eSpark-Consulting-Group/ezlo-rf-ir-blaster/README.md

# Scope of Work

1. The first task will be to convert the design from KiCAD into Altium.
2. This will be followed by a review phase where the whole design will be checked thoroughly for any errors or issues or enhancements. This will be done keeping in mind that prototypes of this design are are already tested and working properly.
3. After this, the design will be forwarded to fabrication.
