eSpark-Consulting-Group/ezlo-rf-ir-blaster/docs/Client-Files/IR-RF Blaster revA/BOM/ir-rf-blaster-bom-revA.xls

IR-RF-BLaster revA BOM - Exported April 3rd 2023
Ref | Qnty | Value | Voltage | Cmp name | Footprint | Description | Assembly | LCSC # | Mfr | MPN
AE1, | 1 | Antenna |  | Antenna | Ezlo:RF-433-Helical | Antenna | YES | C381188 | DreamLNK |  | https://datasheet.lcsc.com/lcsc/1912111437_DreamLNK-T14-433M_C381188.pdf
C1, C11, | 2 | 1uF |  | C | Capacitor_SMD:C_0402_1005Metric | Unpolarized capacitor | YES | C1592 | CL10A105KO8NNNC
C2, C9, | 2 | 22uF |  | C | Capacitor_SMD:C_1206_3216Metric | Unpolarized capacitor | YES | C408152 | GRM31CR70J226KE19L
C3, C4, C10, | 3 | 0.1uF |  | C | Capacitor_SMD:C_0402_1005Metric | Unpolarized capacitor | YES | C24452 | CL10B104JB8NNNC
C5, | 1 | 4.7uF |  | C | Capacitor_SMD:C_0402_1005Metric | Unpolarized capacitor | YES | C1705 | CL10A475KP8NNNC
C6, C7, | 2 | 220uF | 10V | C_Polarized_US | Capacitor_SMD:CP_Elec_6.3x5.4 | Polarized capacitor, US symbol | YES | C267466 | RT1A221M0605
C8, | 1 | 10uF | 16V | C | Capacitor_SMD:C_0603_1608Metric | Unpolarized capacitor | YES | C92487 | CL10A106MO8NQNC
D1, | 1 | LED_GREEN |  | LED_GREEN | LED_SMD:LED_0603_1608Metric | LED GREEN 0603, high efficiency, Vf=3.0V | YES | C84267 | NCD0603G1
D2, D3, D4, D5, D6, D7, D8, D9, | 8 | IR333-A |  | LED_Filled | LED_THT:LED_D5.0mm | Light emitting diode, filled shape | YES | C95407 | IR333-A
D10, | 1 | SMF5.0CA |  | SMF5V0A | Diode_SMD:D_SMF | 200W unidirectional Transil Transient Voltage Suppressor, 5Vrwm, SMF | YES | C2980402 | SMF5.0CA
F1, | 1 | 1A |  | Polyfuse | Fuse:Fuse_0603_1608Metric | Resettable fuse, polymeric positive temperature coefficient | YES | C2757929 | BSMD0603L-100
H1, H2, | 2 | MountingHole |  | MountingHole | MountingHole:MountingHole_2.2mm_M2 | M2 screw, self tapping | YES | - | screw
J1, | 1 | VoltLink_target |  | VoltLink_target | Voltlog:VoltLink-vertical | Voltlog Link ESP programming header, pinout designed for target side. | DNP | C145963
J2, | 1 | TYPE-C-31-M-17 |  | USB_C_Receptacle_PowerOnly_6P | Ezlo:TYPE-C-31-M-17 | USB Power-Only 6P Type-C Receptacle connector | YES | C283540 | TYPE-C-31-M-17
Q1, | 1 | YJL2302B |  | DMG2302U | Package_TO_SOT_SMD:SOT-23 | 4.2A Id, 20V Vds, N-Channel MOSFET, SOT-23 | YES | C699316 | YJL2302B
R1, R3, R10, | 3 | 10K |  | R_US | Resistor_SMD:R_0402_1005Metric | Resistor, US symbol | YES |  | GENERIC 1%
R2, | 1 | 1K |  | R_US | Resistor_SMD:R_0402_1005Metric | Resistor, US symbol | YES |  | GENERIC 1%
R4, R9, | 2 | 100R |  | R_US | Resistor_SMD:R_0402_1005Metric | Resistor, US symbol | YES |  | GENERIC 1%
R5, R6, R7, R8, | 4 | 14R |  | R_US | Resistor_SMD:R_1210_3225Metric | Resistor, US symbol | YES |  | GENERIC 1%
R11, R12, | 2 | 5K1 |  | R_US | Resistor_SMD:R_0402_1005Metric | Resistor, US symbol | YES | C25905 | GENERIC 1%
SW1, | 1 | USER |  | SW_Push | Ezlo:Switch_YTS-B003-2A | Push button switch, generic, two pins | YES | C2910695 | YTS-B003-2A
U1, | 1 | ESP32-S3-WROOM-1U-N4 |  | ESP32-S3-WROOM-1 | Espressif:ESP32-S3-WROOM-1 |  | YES | C2913197 | ESP32-S3-WROOM-1-N4
U2, | 1 | IRM-H638T/TR2 |  | IRM-H638T | Package_SO:SO-4_4.4x4.3mm_P2.54mm | Photo Modules for PCM Remote Control Systems | YES | C91447 | IRM-H638T/TR2
U3, | 1 | IRM-3638T |  | TSOP382xx | OptoDevice:Vishay_MINICAST-3Pin | Photo Modules for PCM Remote Control Systems | DNP | C16216
U4, | 1 | LR1107 |  | LR1107 | Package_TO_SOT_SMD:SOT-89-3 | 600mA FAST ULTRA LOW Dropout Regulator | YES | C171498 | LR1107G-33-AB3-C-R
U5, | 1 | E07-400M10S |  | EBYTE-E07-M10S | Ezlo:EBYTE-E07-M10S | EBYTE CC101 based modules E07-400M10S and E07-900M10S 14*20mm size | YES |  | EBYTE-E07-M10S | <--- cost from Ebyte for this module is $1.53/pc @5K qty
N1, | 1 | Housing |  | Housing |  | Housing | YES |  | custom
PCB | 1 |  |  |  | FR4, TG130, HASL, 1.6mm, green soldermask, white silkscreen
Packaging | 1 |  |  |  | Box, User Manual
USB-C Cable | 1 |  |  |  | USB-C to USB Type-A Cable, Power Only, 1m, 5V 1A rating
DNP = DO NOT POPULATE
