eSpark-Consulting-Group/ezlo-rf-ir-blaster/docs/Client-Files/IR-RF Blaster revA/enclosure/IR-New/AssemblyNew.STEP

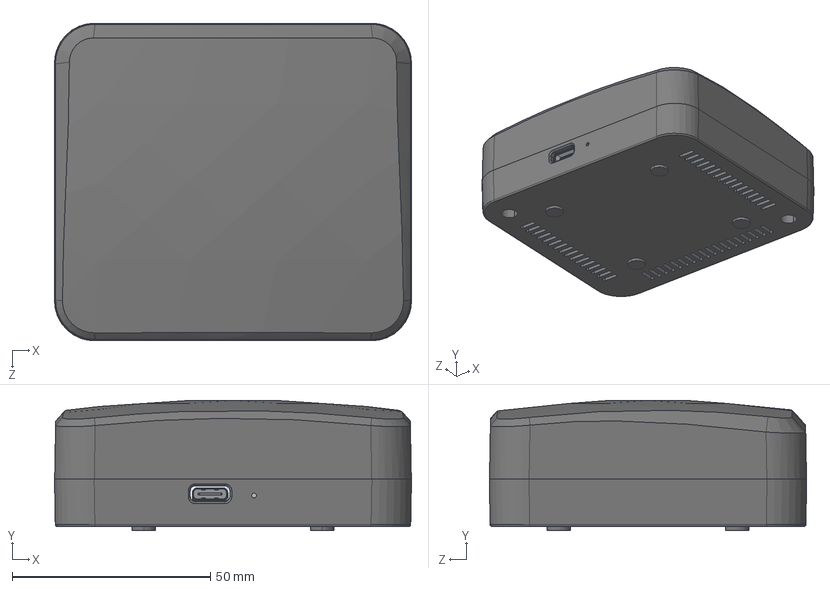
[picture p2: CAD file, 2023-08-09]
docs/Client-Files/IR-RF Blaster revA/enclosure/IR-New/AssemblyNew.STEP
90.1 x 32.8 x 80.1 mm
Body New
SOLID.step x 8
SOLID-0.step
SOLID-1.step
SOLID-2.step
SOLID-3.step x 2
SOLID-4.step
SOLID-5.step x 4
SOLID-6.step x 2
SOLID-7.step
COMPOUND-8.step
SOLID-9.step
SOLID-11.step x 6
COMPOUND-12.step
SOLID-13.step
COMPOUND-14.step
SOLID-15.step
COMPOUND-16.step
PCB.step
led placer new
