eSpark-Consulting-Group/ezlo-rf-ir-blaster/docs/Client-Files/IR-RF Blaster revA/enclosure/IR-New/IR-New/IR_Top.STEP

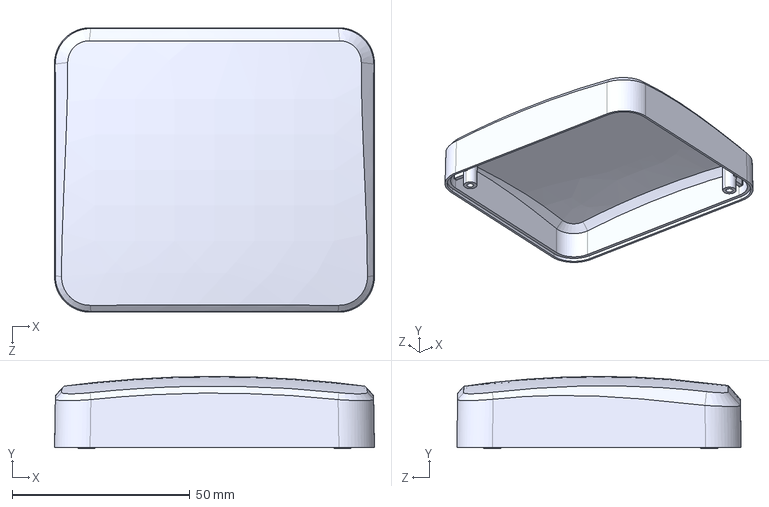
[picture p3: CAD file, 2023-08-09]
docs/Client-Files/IR-RF Blaster revA/enclosure/IR-New/IR-New/IR_Top.STEP
90.0 x 20.3 x 80.0 mm
