eSpark-Consulting-Group/ezlo-rf-ir-blaster/docs/Client-Files/IR-RF Blaster revA/enclosure/IR-New/IR-New/IR_Base.STEP

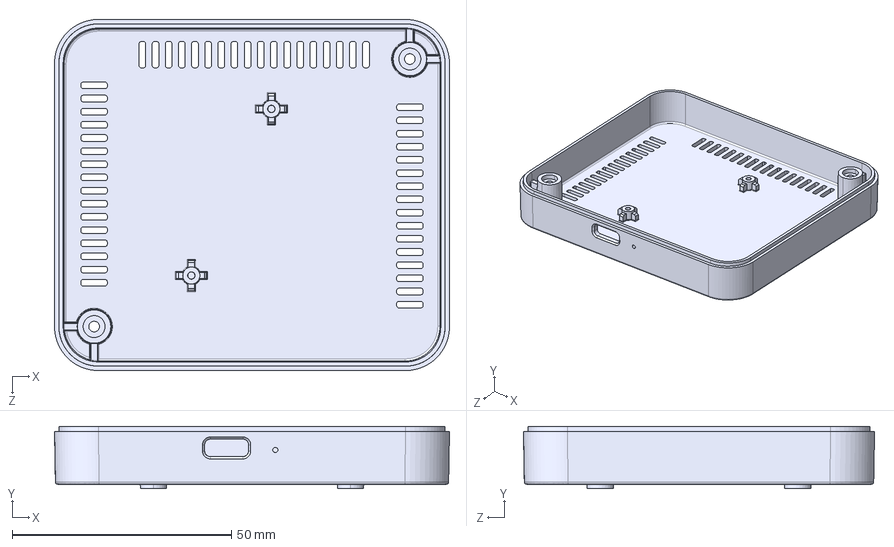
[picture p4: CAD file, 2023-08-09]
docs/Client-Files/IR-RF Blaster revA/enclosure/IR-New/IR-New/IR_Base.STEP
90.1 x 14.2 x 80.1 mm
