eSpark-Consulting-Group/ezlo-rf-ir-blaster/docs/Client-Files/IR-RF Blaster revA/enclosure/IR-New/led placer new.STEP

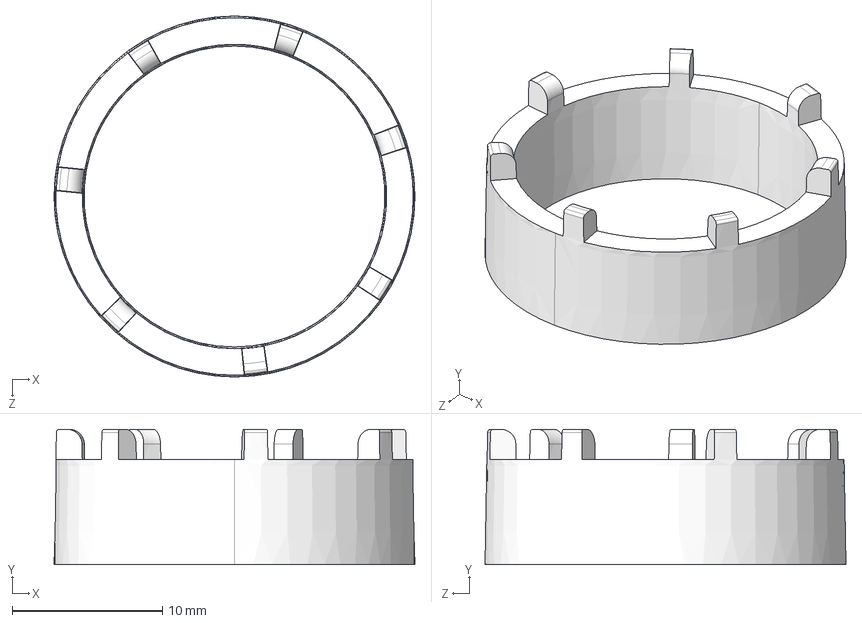
[picture p5: CAD file, 2023-08-09]
docs/Client-Files/IR-RF Blaster revA/enclosure/IR-New/led placer new.STEP
24.0 x 9.00 x 24.0 mm
