eSpark-Consulting-Group/ezlo-rf-ir-blaster/(list of files, cad)

Other CAD files:
docs/Client-Files/IR-RF Blaster revA/enclosure/IR-New/IR-New/IR_Base.SLDPRT
docs/Client-Files/IR-RF Blaster revA/enclosure/IR-New/IR-New/IR_Base.STL
docs/Client-Files/IR-RF Blaster revA/enclosure/IR-New/IR-New/IR_Top.SLDPRT
docs/Client-Files/IR-RF Blaster revA/enclosure/IR-New/IR-New/IR_Top.STL
docs/Client-Files/IR-RF Blaster revA/enclosure/IR-New/IR_Base.SLDPRT
docs/Client-Files/IR-RF Blaster revA/enclosure/IR-New/IR_Base.STL
docs/Client-Files/IR-RF Blaster revA/enclosure/IR-New/IR_Top.SLDPRT
docs/Client-Files/IR-RF Blaster revA/enclosure/IR-New/IR_Top.STL
docs/Client-Files/IR-RF Blaster revA/enclosure/IR-New/led placer new.SLDPRT
docs/Client-Files/IR-RF Blaster revA/enclosure/IR-New/led placer new.STL
