eSpark-Consulting-Group/ezlo-rf-ir-blaster/docs/Client-Files/IR-RF Blaster revA/IR-RF-Blaster revA Schematic.pdf

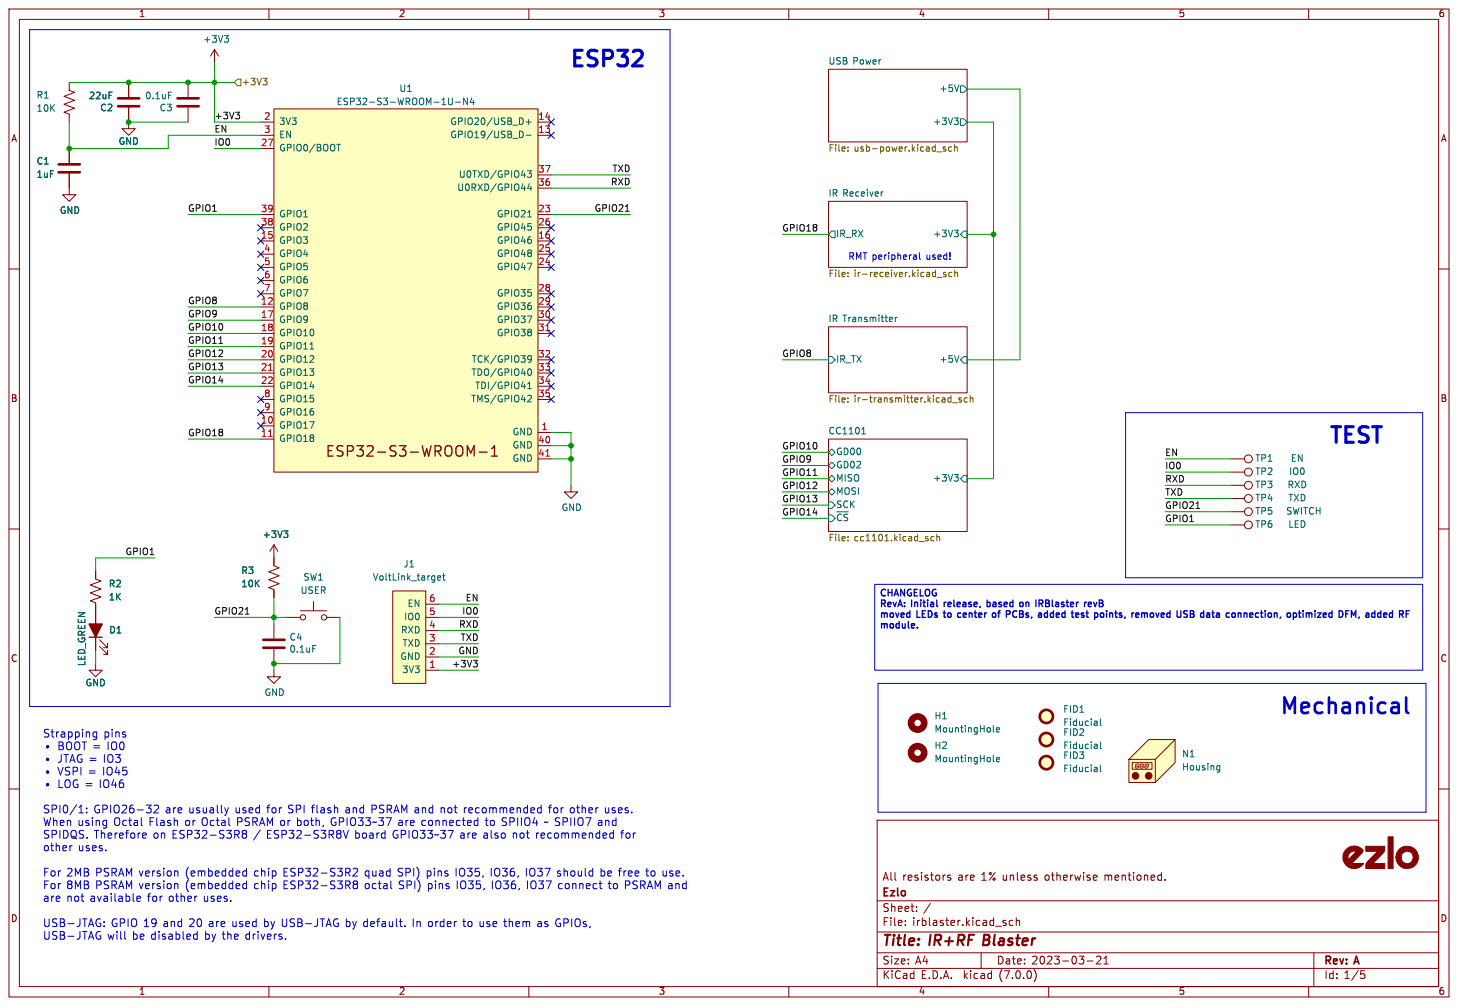
[picture p6: page 1]

IR Receiver File: ir-receiver.kicad_sch+5V

IR Transmitter File: ir-transmitter.kicad_sch

+3V3 ~{CS} SCK MOSI MISO

RevA: Initial release, based on IRBlaster revB moved LEDs to center of PCBs, added test points, removed USB data connection, optimized DFM, added RF module. +3V3 R3

Id: 1/5 Title: IR+RF Blaster File: irblaster.kicad_sch Sheet: / Ezlo All resistors are 1% unless otherwise mentioned.

are not available for other uses. USB-JTAG: GPIO 19 and 20 are used by USB-JTAG by default. In order to use them as GPIOs, USB-JTAG will be disabled by the drivers.

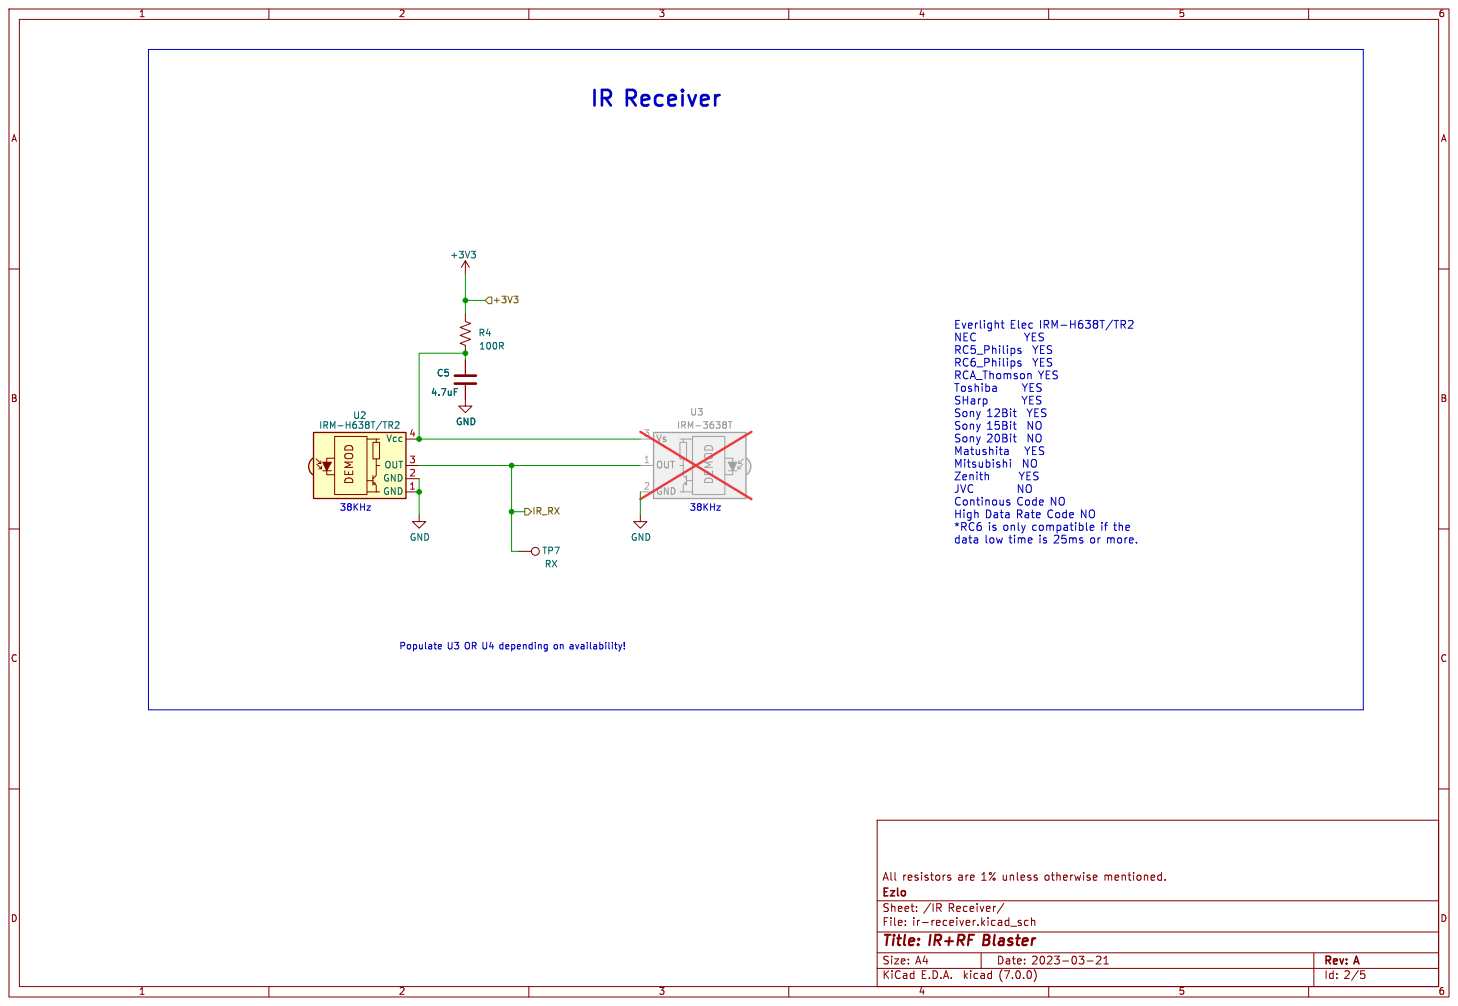
[picture p7: page 2]

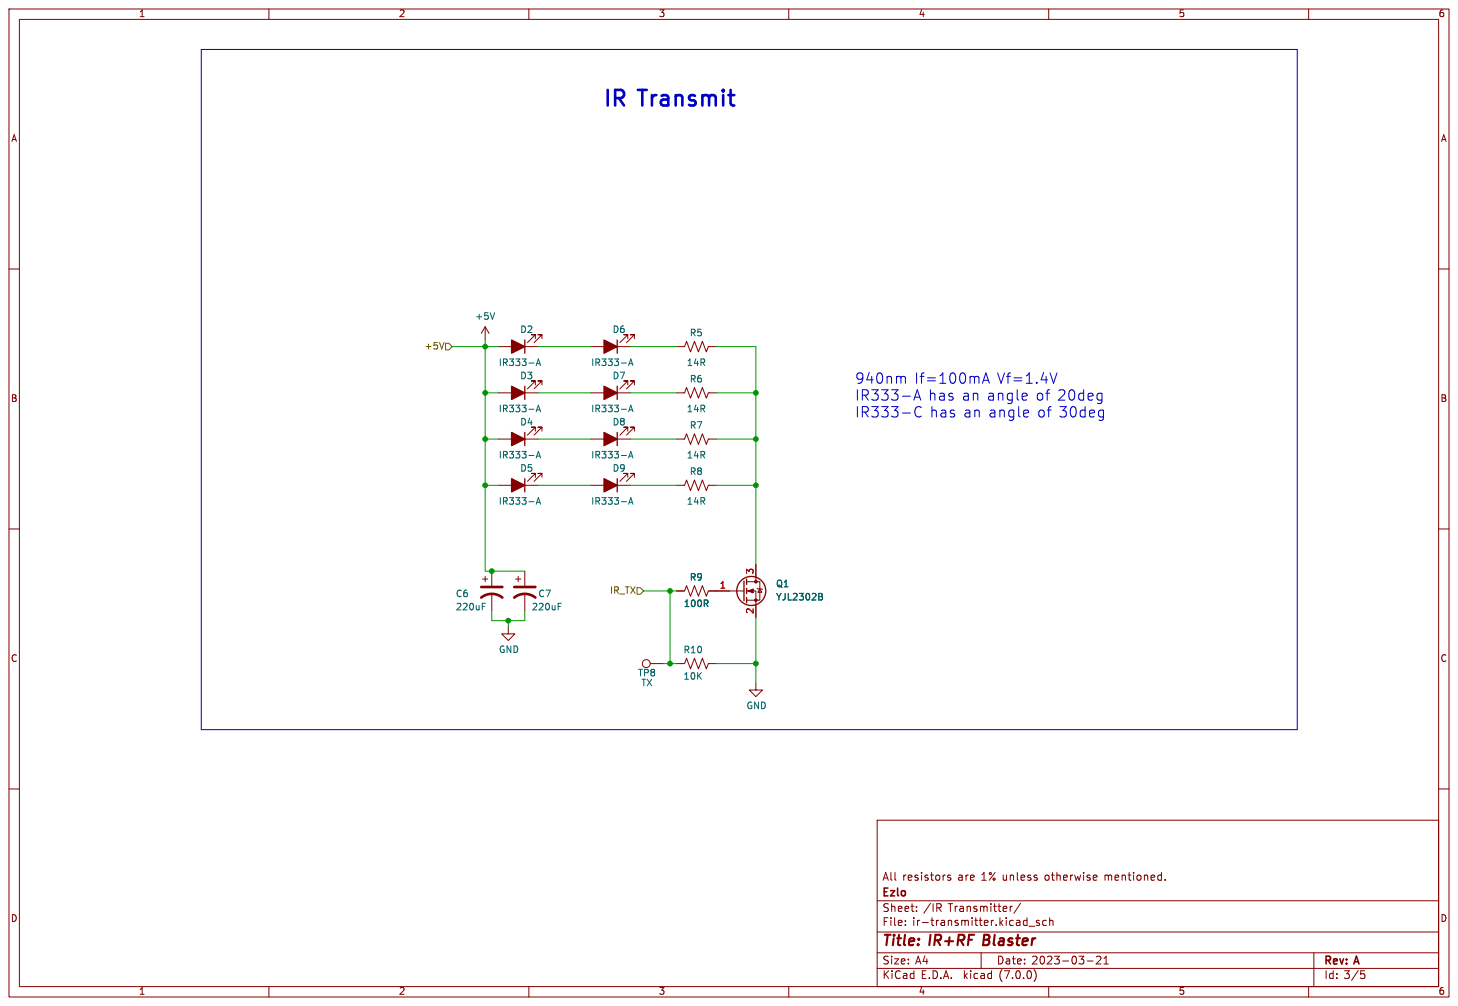
[picture p8: page 3]

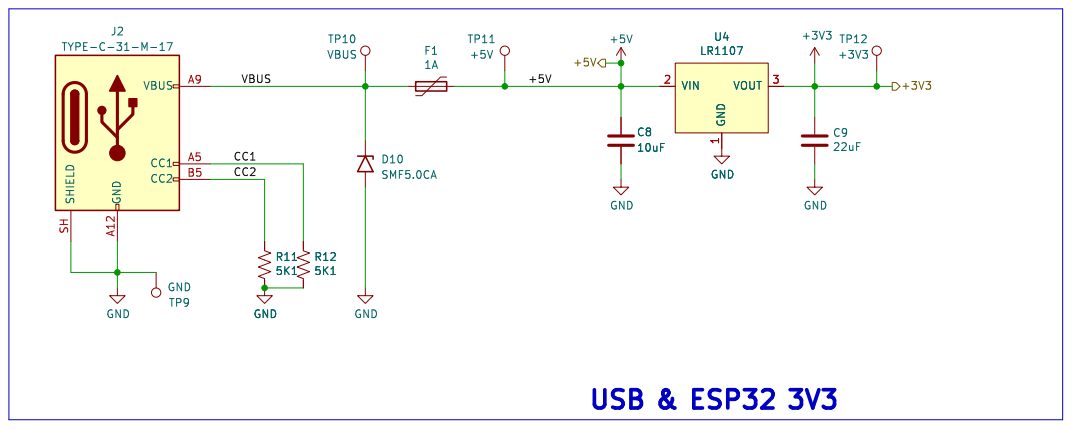
[picture p9: page 4]

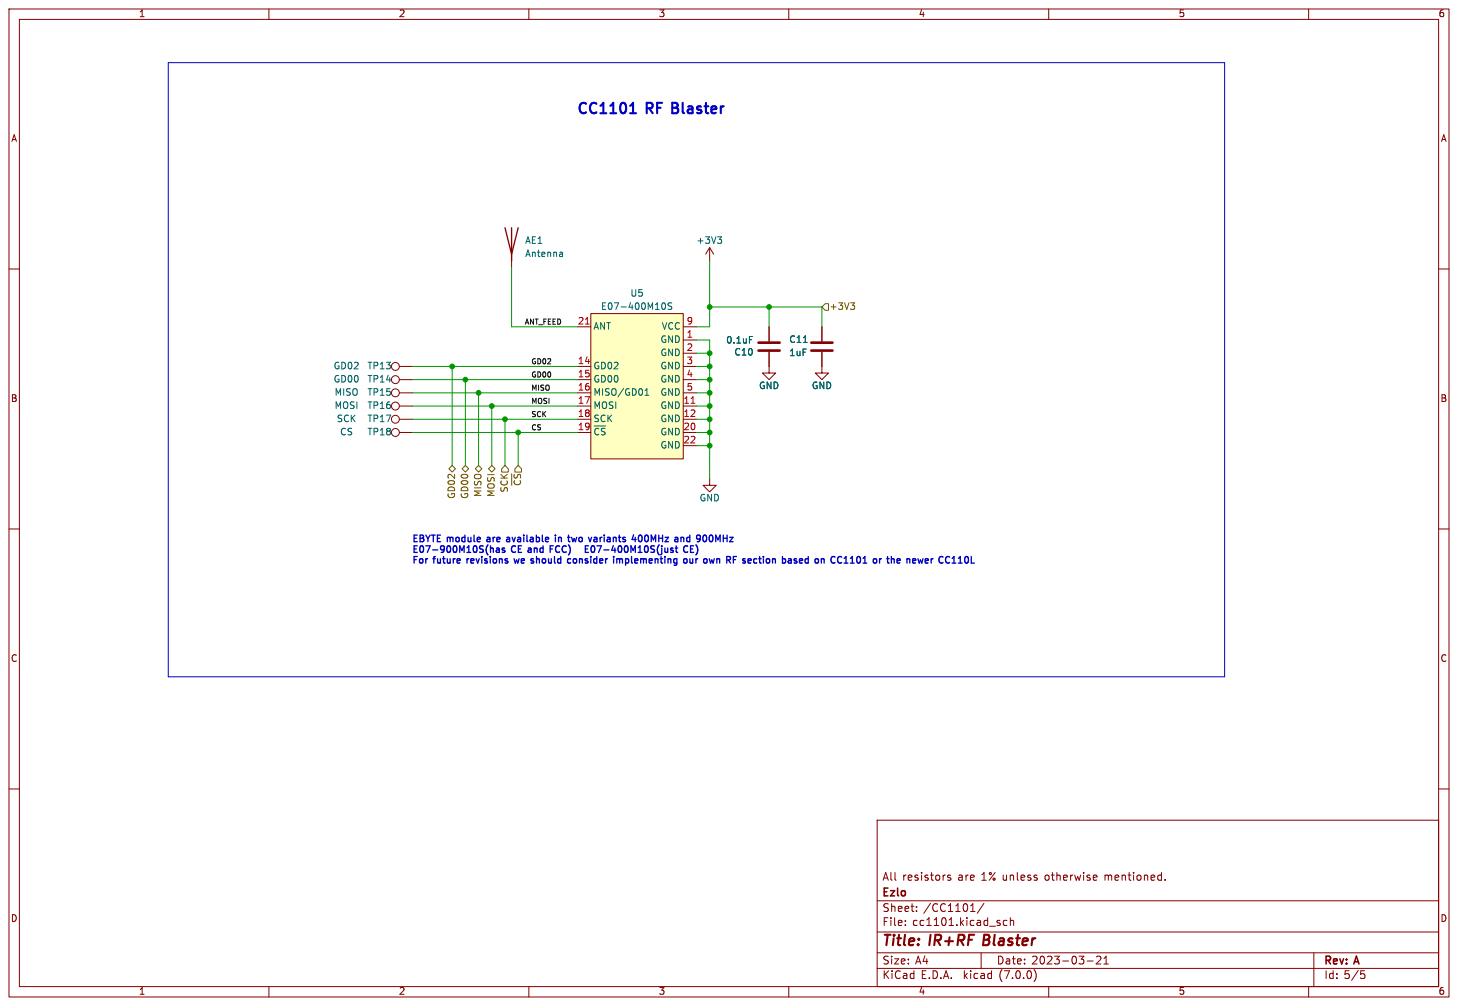
[picture p10: page 5]

Id: 5/5 Title: IR+RF Blaster File: cc1101.kicad_sch Sheet: /CC1101/ Ezlo All resistors are 1% unless otherwise mentioned. GND
