eSpark-Consulting-Group/ezlo-rf-ir-blaster/(list of files, drawings)

Other design files:
Design-Files/RF-IR-Blaster-v1.0/RF-IR-Blaster-v1.0.PcbDoc
Design-Files/RF-IR-Blaster-v1.0/RF-IR-Blaster-v1.0.PrjPcb
