eSpark-Consulting-Group/ezlo-rf-ir-blaster/docs/Client-Files/IR-RF Blaster revA/irblaster.kicad_pcb

## KiCad design docs/Client-Files/IR-RF Blaster revA/irblaster.kicad_pcb (2023-08-16)

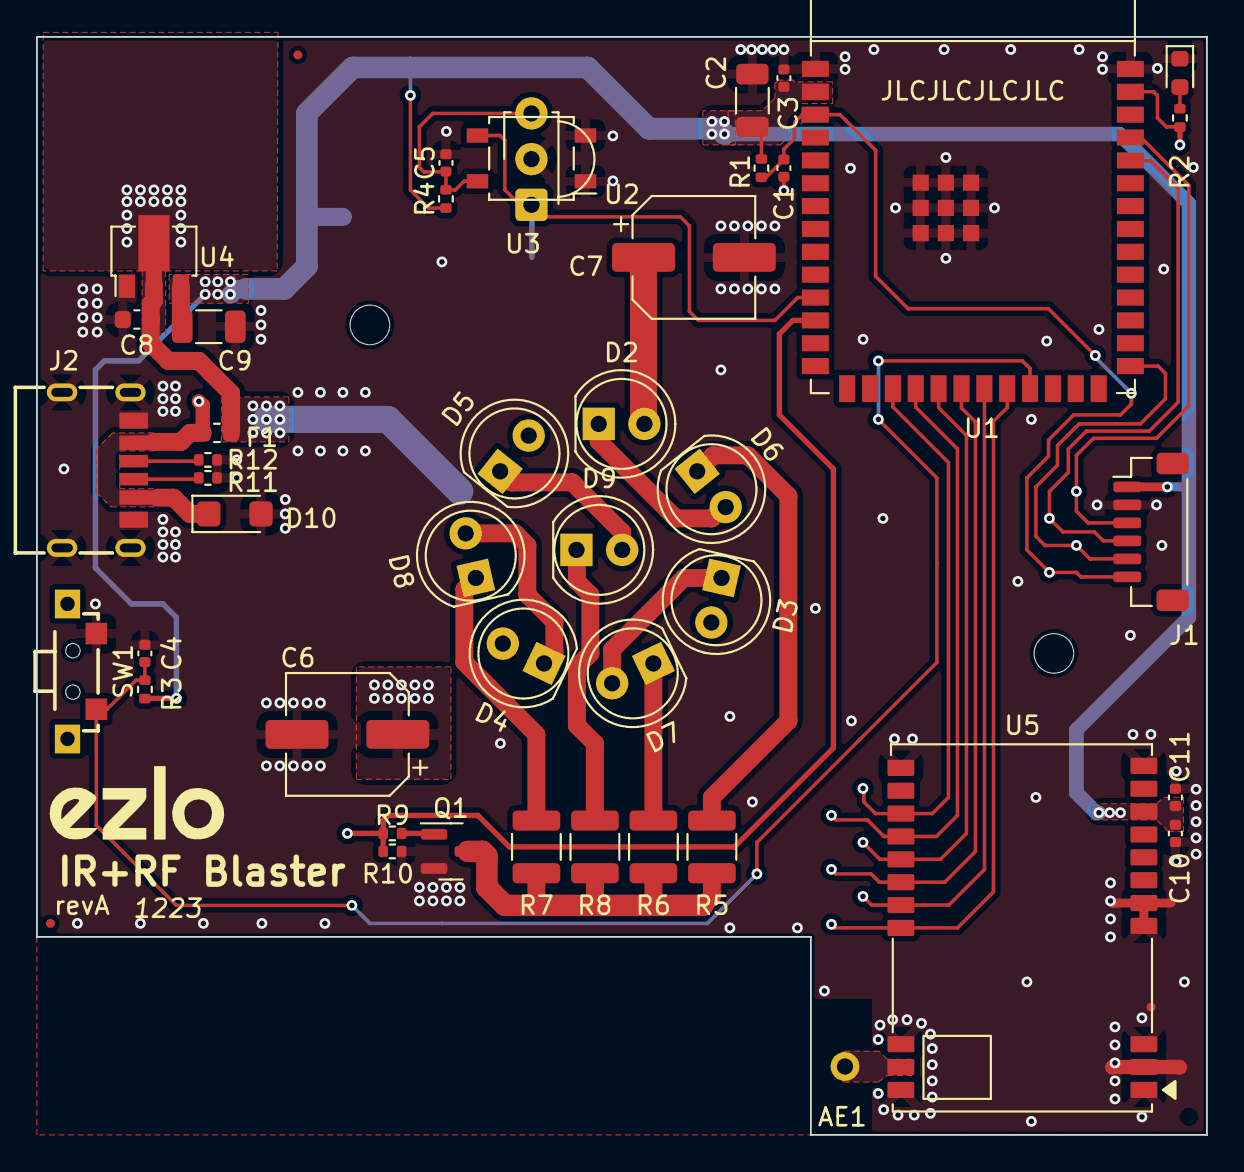
[picture p11: board irblaster.kicad_pcb from above]

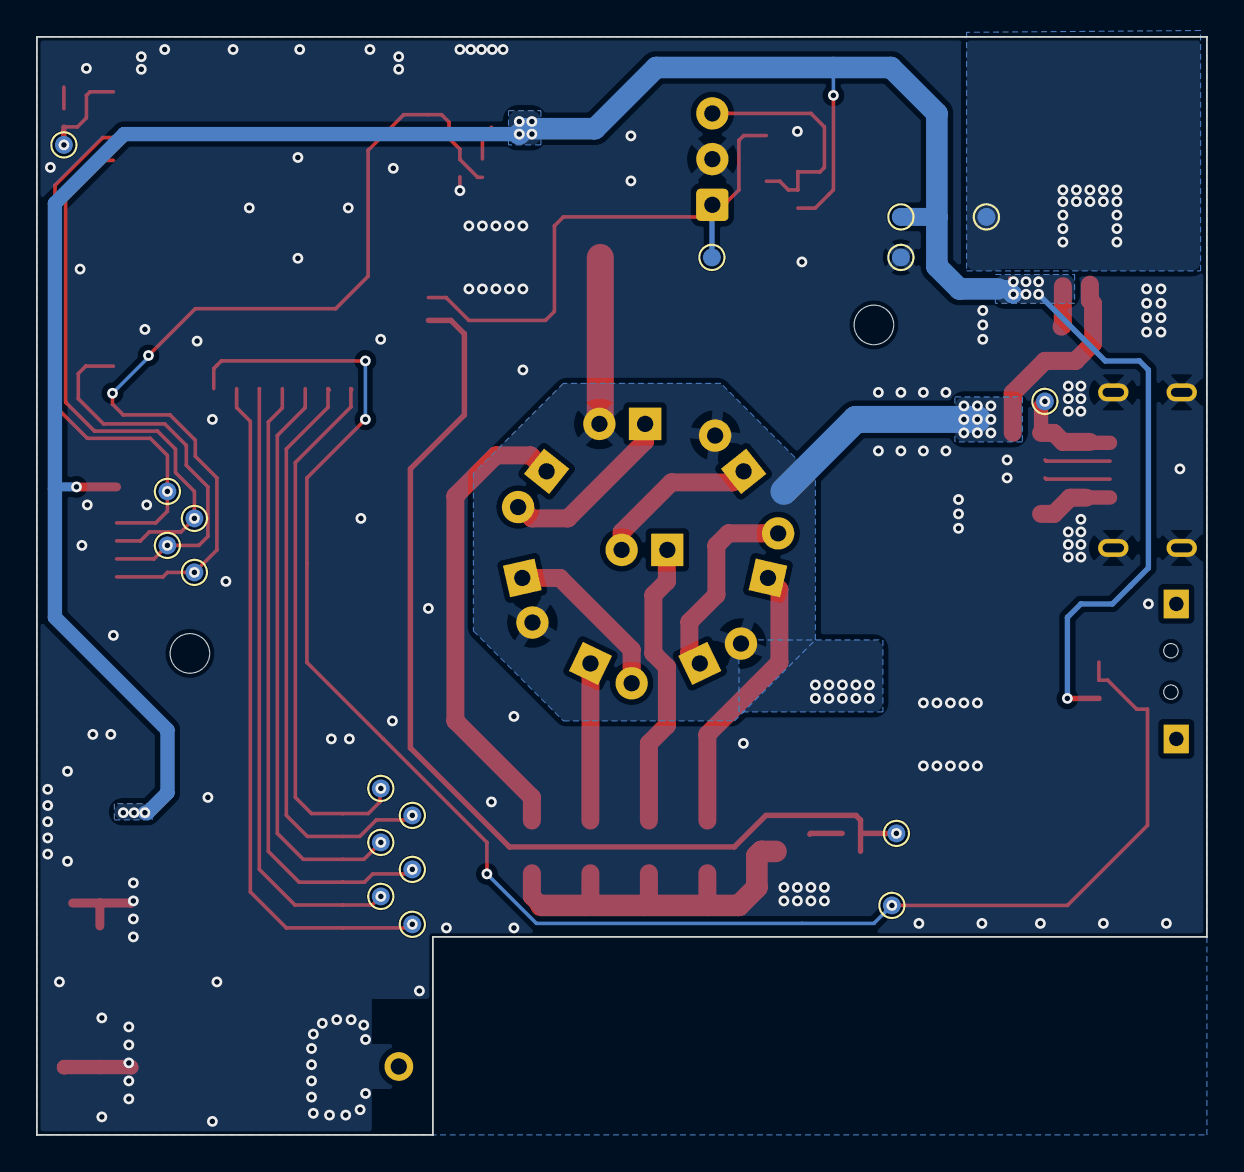
[picture p12: board irblaster.kicad_pcb from below]

Board: 2 copper layers, 65.0 x 61.0 mm, 68 parts (18 on the bottom side), 33 nets.

Parts:
AE1: Antenna; RF-433-Helical
C1, C11: 1uF; C_0402_1005Metric
C2, C9: 22uF; C_1206_3216Metric
C3, C4, C10: 0.1uF; C_0402_1005Metric
C5: 4.7uF; C_0402_1005Metric
C6, C7: 220uF; CP_Elec_6.3x5.4
C8: 10uF; C_0603_1608Metric
D1: LED_GREEN; LED_0603_1608Metric
D2, D3, D4, D5, D6, D7, D8, D9: IR333-A; LED_D5.0mm
D10: SMF5.0CA; D_SMF
F1: 1A; Fuse_0603_1608Metric
FID1, FID2, FID3: Fiducial; Fiducial_0.5mm_Mask1mm
H1, H2: MountingHole; MountingHole_2.2mm_M2
J1: VoltLink_target; VoltLink-vertical
J2: TYPE-C-31-M-17
Q1: YJL2302B; SOT-23
R1, R3, R10: 10K; R_0402_1005Metric
R2: 1K; R_0402_1005Metric
R4, R9: 100R; R_0402_1005Metric
R5, R6, R7, R8: 14R; R_1210_3225Metric
R11, R12: 5K1; R_0402_1005Metric
SW1: USER; Switch_YTS-B003-2A
TP1: EN; TestPoint_Pad_D1.0mm
TP2: IO0; TestPoint_Pad_D1.0mm
TP3: RXD; TestPoint_Pad_D1.0mm
TP4: TXD; TestPoint_Pad_D1.0mm
TP5: SWITCH; TestPoint_Pad_D1.0mm
TP6: LED; TestPoint_Pad_D1.0mm
TP7: RX; TestPoint_Pad_D1.0mm
TP8: TX; TestPoint_Pad_D1.0mm
TP9: GND; TestPoint_Pad_D1.0mm
TP10: VBUS; TestPoint_Pad_D1.0mm
TP11: +5V; TestPoint_Pad_D1.0mm
TP12: +3V3; TestPoint_Pad_D1.0mm
TP13: GD02; TestPoint_Pad_D1.0mm
TP14: GD00; TestPoint_Pad_D1.0mm
TP15: MISO; TestPoint_Pad_D1.0mm
TP16: MOSI; TestPoint_Pad_D1.0mm
TP17: SCK; TestPoint_Pad_D1.0mm
TP18: CS; TestPoint_Pad_D1.0mm
U1: ESP32-S3-WROOM-1U-N4; ESP32-S3-WROOM-1
U2: IRM-H638T/TR2; SO-4_4.4x4.3mm_P2.54mm
U3: IRM-3638T; Vishay_MINICAST-3Pin
U4: LR1107; SOT-89-3
U5: E07-400M10S; EBYTE-E07-M10S
V1: EZLO_LOGO; Logo Ezlo_M

Connections:
+3V3: C2.2, C3.2, C9.1, C10.2, C11.1, J1.1 (3V3), R1.2, R3.2, R4.1, TP12.1, U1.2 (3V3), U4.3 (VOUT), U5.9 (VCC)
+5V: C6.1, C7.1, C8.1, D2.2 (A), D3.2 (A), D4.2 (A), D5.2 (A), F1.1, TP11.1, U4.2 (VIN)
/CC1101/ANT_FEED: AE1.1 (A), U5.21 (ANT)
/EN: C1.1, J1.6 (EN), R1.1, TP1.1, U1.3 (EN)
/GPIO1: R2.1, TP6.1, U1.39 (GPIO1)
/GPIO8: R9.2, R10.2, TP8.1, U1.12 (GPIO8)
/GPIO9: TP13.1, U1.17 (GPIO9), U5.14 (GD02)
/GPIO10: TP14.1, U1.18 (GPIO10), U5.15 (GD00)
/GPIO11: TP15.1, U1.19 (GPIO11), U5.16 (MISO/GD01)
/GPIO12: TP16.1, U1.20 (GPIO12), U5.17 (MOSI)
/GPIO13: TP17.1, U1.21 (GPIO13), U5.18 (SCK)
/GPIO14: TP18.1, U1.22 (GPIO14), U5.19 (~CS)
/GPIO18: TP7.1, U1.11 (GPIO18), U2.3 (OUT), U3.1 (OUT)
/GPIO21: C4.1, R3.1, SW1.1, TP5.1, U1.23 (GPIO21)
/IO0: J1.5 (IO0), TP2.1, U1.27 (GPIO0/BOOT)
/RXD: J1.4 (RXD), TP3.1, U1.36 (U0RXD/GPIO44)
/TXD: J1.3 (TXD), TP4.1, U1.37 (U0TXD/GPIO43)
/USB Power/CC1: J2.A5 (CC1), R12.1
/USB Power/CC2: J2.B5 (CC2), R11.1
/USB Power/VBUS: D10.1 (A1), F1.2, J2.A9 (VBUS), J2.B9 (VBUS), TP10.1
GND: C1.2, C2.1, C3.1, C4.2, C5.2, C6.2, C7.2, C8.2, C9.2, C10.1, C11.2, D1.1 (K), D10.2 (A2), J1.2 (GND), J2.A12 (GND), J2.B12 (GND), J2.SH (SHIELD), Q1.2 (S), R10.1, R11.2, R12.2, SW1.2, TP9.1, U1.1 (GND), U1.40 (GND), U1.41 (GND), U2.1 (GND), U2.2 (GND), U3.2 (GND), U4.1 (GND), U5.1 (GND), U5.2 (GND), U5.3 (GND), U5.4 (GND), U5.5 (GND), U5.11 (GND), U5.12 (GND), U5.20 (GND), U5.22 (GND)
unnamed: D1.2 (A), R2.2
unnamed: D2.1 (K), D6.2 (A)
unnamed: D3.1 (K), D7.2 (A)
unnamed: D4.1 (K), D8.2 (A)
unnamed: D5.1 (K), D9.2 (A)
unnamed: D6.1 (K), R5.2
unnamed: D7.1 (K), R6.2
unnamed: D8.1 (K), R7.2
unnamed: D9.1 (K), R8.2
unnamed: Q1.3 (D), R5.1, R6.1, R7.1, R8.1
unnamed: Q1.1 (G), R9.1
unnamed: C5.1, R4.2, U2.4 (Vcc), U3.3 (Vs)
