eSpark-Consulting-Group/ezlo-rf-ir-blaster/docs/Client-Files/IR-RF Blaster revA/known issues revA.txt

1. U5 E07-400M10S CC1101 module footprint is incorrect, does not match part perfectly.
