eSpark-Consulting-Group/ezlo-rf-ir-blaster/(commit log)

2023-08-09 KiCad Files pushed
    [AssemblyNew.STEP, IR_Base.SLDPRT, IR_Base.STEP, IR_Base.STL, IR_Top.SLDPRT, IR_Top.STEP, IR_Top.STL, JLCPCB_position_revA.xlsx]
2023-08-10 #1 Schematic Design v1.0
    #1 Schematic Design v1.0
    [RF-IR-Blaster-v1.0.PrjPcb]
2023-08-10 #1 Validated Schematics
    Validated Schematics
    [RF-IR-Blaster-v1.0.PrjPcb]
2023-08-15 #3 Placement completed, Routing in Progress
    [RF-IR-Blaster-v1.0.PcbDoc, RF-IR-Blaster-v1.0.PrjPcb]
2023-08-16 #3 Routing completed no DRC error
    [RF-IR-Blaster-v1.0.PcbDoc, RF-IR-Blaster-v1.0.PrjPcb]
2023-08-17 through hole Test point and overlay update
    [RF-IR-Blaster-v1.0.PcbDoc, irblaster.kicad_pcb]
2023-12-06 SR Latch and New Regulator ICs Added
2023-12-21 #5 In progress
    [RF-IR-Blaster-v1.0.PcbDoc, RF-IR-Blaster-v1.0.PrjPcb]
